pravin2007-ctrl/UV_Guard_IoT_project/uv_product_image/WhatsApp Image 2026-10-07 at 12.01.07 PM.jpeg

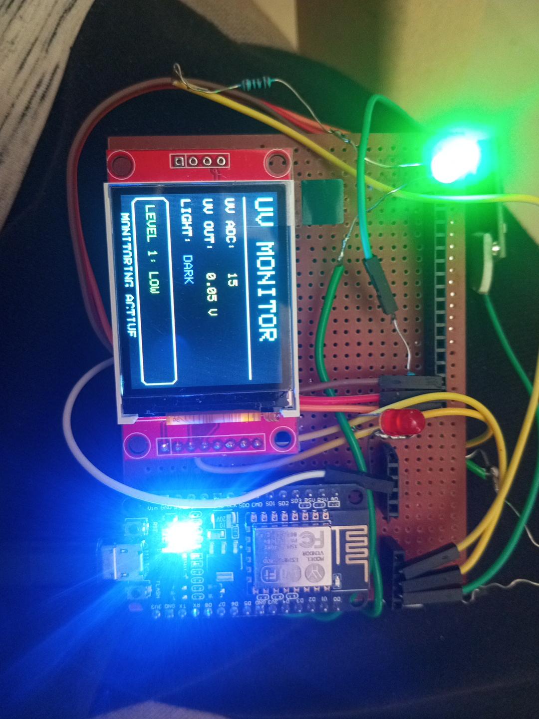
uv_product_image/WhatsApp Image 2026-10-07 at 12.01.07 PM.jpeg
