pravin2007-ctrl/UV_Guard_IoT_project/uv_product_image/38c1b2d2-1b30-4ac0-9bd5-d0442b546b4b.jpg

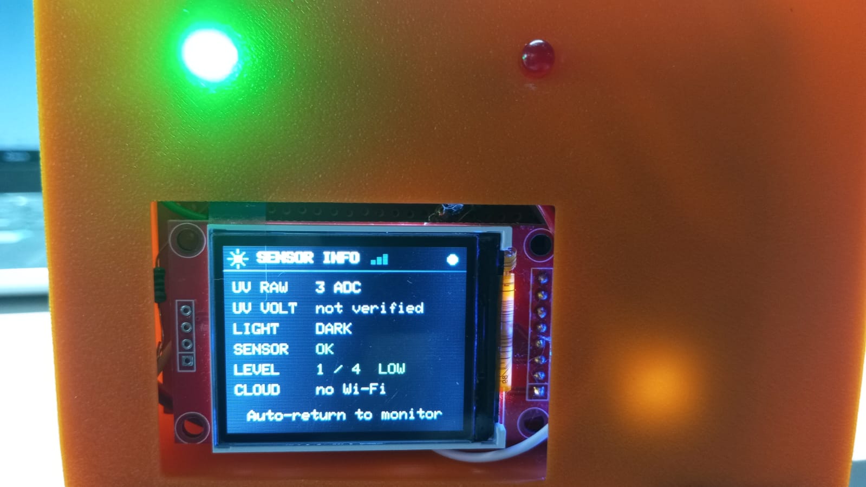
uv_product_image/38c1b2d2-1b30-4ac0-9bd5-d0442b546b4b.jpg
