pravin2007-ctrl/UV_Guard_IoT_project/UV_Guard_Final.pptx

Smart UV Risk Classification and Ambient Light Monitoring System Using ESP8266 with ThingSpeak Cloud Connectivity

STUDENT NAME

Pravin A

REGISTER NUMBER

722824106121

YEAR / DEPT / SECTION

III Year / ECE / C

COURSE CODE & NAME

U23EC492 - IoT and Application

DATE

SDG ADDRESSED

SDG 3 - Good Health & Well-being
SDG 7 - Affordable & Clean Energy

Supervisor: Dr. S. Ramalingam, AP/ECE | Sri Eshwar College of Engineering, Coimbatore

TRL

TRL 4 - Experimental Proof of Concept

## Introduction

BACKGROUND

- UV radiation (100-400 nm) is invisible; UVA and UVB reach the ground
- Causes sunburn, photokeratitis, skin ageing, cataracts, skin cancer

MOTIVATION & IMPORTANCE

- Strong year-round UV in tropical India; outdoor workers and students exposed
- Forecasts are regional; calibrated meters are costly

TECHNICAL CONTEXT

- ESP8266 NodeMCU reads an analog UV sensor (10-bit ADC, 0-1023)
- LDR light state, TFT + LEDs, ThingSpeak upload over Wi-Fi

PROJECT OBJECTIVES

- Measure, filter and classify UV into 4 levels with hysteresis
- Local TFT/LED alert; 16 s cloud upload; works offline; test mode

## Problem Statement

THE PROBLEM

- UV cannot be seen or felt, so safe/unsafe levels cannot be judged by eye
- No affordable, local, real-time notification between forecasts and costly meters
- Hobby designs print raw values: no risk level, advice or light context

IMPACT

- Exposure is underestimated, even on hazy or cloudy days
- Risk of sunburn, eye damage and skin cancer for outdoor workers and students
- Uncalibrated 'UV Index' claims can mislead users

NEED FOR THE SOLUTION

- Low-cost, portable, local UV measurement
- Named risk levels with colour, LEDs and advice
- Stable readings; no display flicker
- Works offline; cloud monitoring optional

## Literature Survey

Approach | Methodology | Findings / strengths | Limitations
Professional UV meters | Calibrated detector with erythemal weighting | Most trustworthy local readings | High cost; needs trained interpretation
Forecast apps / websites | UV Index estimated from solar elevation, ozone, cloud | Free and widely available | Regional; ignores shade, reflection, altitude
Wearable UV sensors | Body-worn sensors or patches with phone link | Personal exposure tracking | Orientation-dependent accuracy; consumer products
Microcontroller UV monitors | Analog/digital UV sensor on Arduino/ESP; serial, LCD/OLED; ThingSpeak or Blynk | Low cost and flexible | Raw voltages shown as UV Index; calibration not described
IoT environmental stations | Multi-sensor node (UV, temperature, humidity, pressure) to cloud | Long-term records | Needs network to view; no local alert

## Existing Solutions & Gaps Analyzed

EXISTING APPROACHES AND LIMITS

- Professional meters: accurate but costly, number only
- Forecast apps: regional, not at the user's spot
- Wearables: placement-dependent, single-purpose
- Hobby monitors: raw values, uncalibrated, basic UI
- IoT stations: network-dependent, no local alert
- Unfiltered ADC noise; full-screen redraw flicker

GAPS ADDRESSED BY UV GUARD

- Local, low-cost UV sensing at the device
- Four named levels with colour and advice
- Instant green/red LED alert
- Averaging, smoothing, hysteresis, partial redraw
- LDR bright/dark context for readings
- Local operation continues without Wi-Fi
- Value labelled as raw ADC until calibrated

## Proposed Solution

Sample UV on A0 every 25 ms

1 s mean + exponential filter

Classify L1-L4 with hysteresis

Update TFT and LEDs

Upload to ThingSpeak every 16 s

IMPLEMENTED

- 4 levels: LOW, MODERATE, HIGH, VERY HIGH (placeholder thresholds 100/200/300)
- LDR bright/dark with 3 s debounce
- 3-screen TFT dashboard; green (L1-2) / red (L3-4) LEDs
- NO SIGNAL / SATURATED sensor checks
- Serial test mode (levels forced 15 s)
- ThingSpeak upload; offline operation

## Block Diagram

UV Guard Smart Monitoring Block Diagram

## Prototype Image (Hardware)

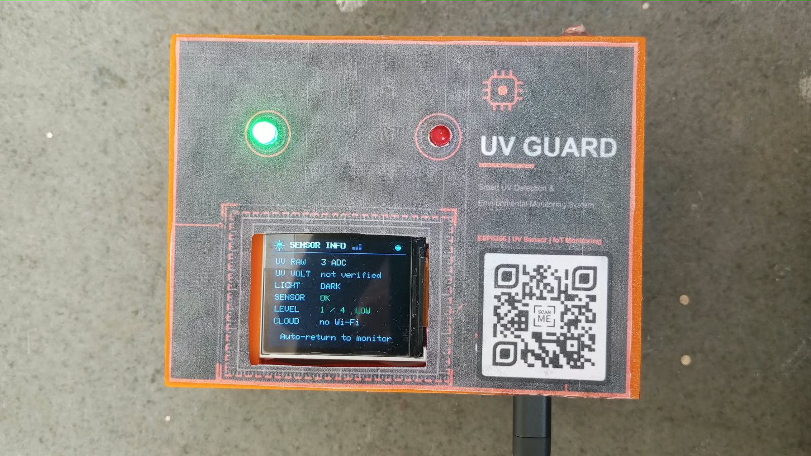
[picture p20: figure]
Enclosure with display

VISIBLE IN PHOTOS

- NodeMCU ESP8266
- 1.8" ST7735 TFT
- UV sensor and LDR
- Green and red LEDs
- 3D-printed case with QR label
- USB power cable

Report lists an enclosure as future work, but the cost sheet includes a 3D-printed case. Confirm.

## Prototype Image (Software): Primary Interface

Remote dashboard: UV sensor ADC vs time from cloud uploads. The report calls it ThingSpeak, but the UI looks like a custom page - confirm.

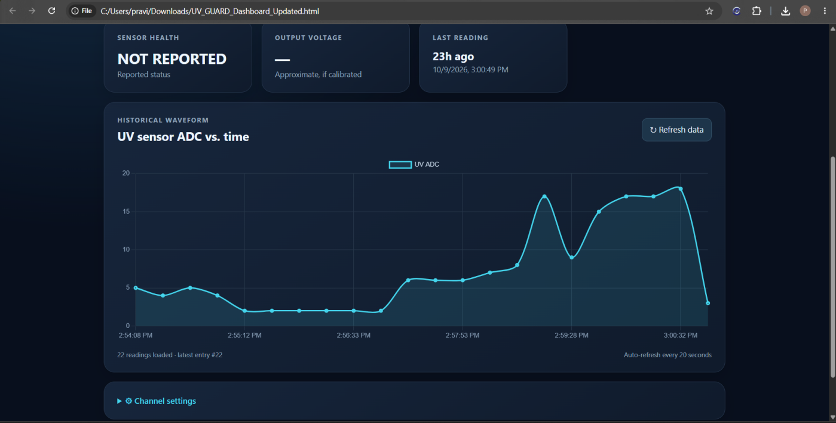
[picture p21: figure]
Cloud dashboard

On-device TFT startup screen

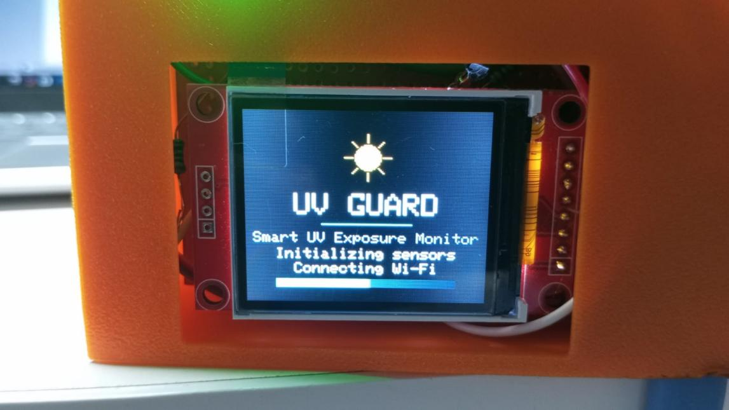
[picture p22: figure]
TFT startup screen

## Prototype Image (Software): Results / Output

Arduino IDE serial monitor: one line per second with raw value, level, light, sensor and cloud status; cloud upload entries.

Serial monitor

Values from the report's field-test table (Table 14); charted here for display.

- Levels and LEDs verified by forcing levels 1-4 (test mode); cloud, offline and failed-upload behaviour tested
- Raw ADC counts, placeholder thresholds: levels are 'sensor risk', not UV Index
- Report lists the shade reading (120) with light state 'off' - confirm

## Technology Stack Used

CONTROLLER & SENSORS

- NodeMCU ESP8266 (ESP-12E), 80 MHz, Wi-Fi
- Analog UV sensor (GUVA-S12SD or similar)
- 5 mm LDR with 10 k divider

DISPLAY & ALERTS

- 1.8" 128x160 ST7735 SPI TFT
- Green and red LEDs (220 ohm)
- 3D-printed enclosure (cost sheet)

COMMUNICATION

- ADC (A0), GPIO, hardware SPI
- UART / USB serial, 115200 baud
- Wi-Fi 802.11 b/g/n; HTTP over TCP/IP

SOFTWARE

- C++ on Arduino framework; Arduino IDE
- ESP8266 core, ESP8266WiFi, HTTPClient
- Adafruit GFX, ST7735/ST7789, SPI

CLOUD

- ThingSpeak channel (3 fields)
- Upload every 16 s (free tier limit)
- Credentials kept in secrets.h

SIMULATION TOOLS

- None stated in the report
- Testing by serial monitor and field readings

## Specifications: Hardware Components

S.No. | Hardware Components | Specifications | Cost (Rs.)
1 | NodeMCU ESP8266 (ESP-12E) x1 | 80 MHz, integrated Wi-Fi, USB, 10-bit ADC (A0) | 350
2 | Analog UV sensor x1 | Analog output to A0; exact model to be confirmed | 200
3 | 1.8" TFT, ST7735 x1 | 128 x 160, SPI, 3.3 V, landscape use | 370
4 | 5 mm LDR x1 | Two-terminal; bright/dark input on D1 | 40
5 | Resistors: 10 k x1, 220 ohm x2 | LDR divider; LED current limiting | 10
6 | Green LED x1, Red LED x1 | On D2 (levels 1-2) and D0 (levels 3-4) | 10
7 | Jumper wires | As required | 100
8 | Dotboard | 1 piece, circuit assembly | 100
9 | USB cable | Programming and 5 V power | 100
10 | 3D-printed case x1 | Enclosure (cost sheet only) | 150
11 | Product sticker x1 | Label | 20
| Total (sum of line items) | | 1,400

## Specifications: Software

Category | Item / specification | Remarks
Development | Arduino IDE; board NodeMCU 1.0 (ESP-12E Module) | Version not stated
Language / firmware | C++ (Arduino framework, ESP8266 core) | Non-blocking loop using millis()
Libraries | ESP8266WiFi, ESP8266HTTPClient, WiFiClient, SPI | Wi-Fi, HTTP upload, display bus
Display libraries | Adafruit GFX; Adafruit ST7735 and ST7789 | Version not stated
Cloud platform | ThingSpeak: field 1 ADC level | Upload every 16 s; HTTP timeout 2 s
Signal processing | 25 ms samples; 1 s mean; exponential filter | Hysteresis 8 counts
Thresholds | 100 / 200 / 300 raw ADC counts (placeholders) | Calibration pending
Timing / reliability | LDR debounce 3 s; Wi-Fi retry 20 s | Test mode forces level 15 s

## Conclusions

UV Guard: a low-cost ESP8266 device that measures UV, classifies it into four risk levels, alerts locally on a TFT and LEDs, and uploads to ThingSpeak.

- All 8 objectives met per report (Table 18)
- Levels and LEDs verified in test mode
- Field readings 2 to 400 raw ADC across 5 conditions
- Uploads about every 16 s; local alerts continue offline

ACHIEVED AND TESTED

## References

[1] WHO, WMO, UNEP and ICNIRP, Global Solar UV Index: A Practical Guide. Geneva: WHO, 2002.
[2] Espressif Systems, ESP8266EX Datasheet.
[3] ESP8266 Community, "Arduino core for ESP8266 WiFi chip," GitHub. https://github.com/esp8266/Arduino
[4] Adafruit Industries, "Adafruit GFX Graphics Library," GitHub. https://github.com/adafruit/Adafruit-GFX-Library
[5] Adafruit Industries, "Adafruit ST7735 and ST7789 Library," GitHub. https://github.com/adafruit/Adafruit-ST7735-Library
[6] The MathWorks, "ThingSpeak IoT Analytics Platform." https://thingspeak.com

[7] GenUV, GUVA-S12SD UV Light Sensor Datasheet.
[8] LAPIS Semiconductor, ML8511 UV Sensor with Voltage Output Datasheet.
[9] Vishay Semiconductors, VEML6075 UVA and UVB Light Sensor with I2C Interface Datasheet.
[10] Lite-On Technology, LTR-390UV-01 Ambient and UV Light Sensor Datasheet.
[11] Silicon Laboratories, Si1145/46/47 Proximity, UV and Ambient Light Sensor IC Datasheet.
[12] Sitronix Technology, ST7735R 262K Color Single-Chip TFT Controller/Driver Datasheet.

## Slide 16

Thank You

Questions and suggestions are welcome

UV Guard | Pravin A | 722824106121
