pravin2007-ctrl/UV_Guard_IoT_project/UV_Guard_Review1.pptx

PROJECT REVIEW 1 | UV GUARD

Smart UV Risk Classification and Ambient Light Monitoring System Using ESP8266 with ThingSpeak Cloud Connectivity

STUDENT NAME

Pravin A

REGISTER NUMBER

722824106121

YEAR / DEPT / SECTION

III Year / ECE / C

COURSE CODE & NAME

U23EC492 - IoT and Application

SDG ADDRESSED

SDG 3 - Good Health & Well-being
SDG 7 - Affordable & Clean Energy

TRL

TRL 4 - Experimental Proof of Concept

REVIEW & DATE

Review 1 |

Supervisor: Dr. S. Ramalingam, AP/ECE | Sri Eshwar College of Engineering, Coimbatore

## Introduction

Invisible risk: UV radiation (100-400 nm) from the Sun cannot be seen or felt, so exposure is easily underestimated.
Health impact: sunburn, photokeratitis, premature skin ageing, cataracts and skin cancer.
Who is exposed: outdoor workers, students and sports participants in tropical India.
Opportunity: an inexpensive analog UV sensor plus the Wi-Fi ESP8266 can warn users where they actually stand.

WHO GLOBAL SOLAR UV INDEX

Low

0-2

Moderate

3-5

High

6-7

Very High

8-10

Objective: a low-cost, portable device that measures UV, classifies risk and alerts the user locally, with optional cloud monitoring.

## Problem Statement

UV is invisible and heat does not track its intensity, so risk cannot be judged by eye

CORE PROBLEM

Design a low-cost, portable embedded system that continuously measures UV radiation, classifies it into easily understood risk categories, and notifies the user through a display and LEDs, while staying extensible to cloud monitoring.

1

2

3

4

5

Weather-app forecasts are regional, not specific to the user's exact spot

Professional UV meters are costly and show a bare number to interpret

Hobby builds print raw sensor values with no risk level, advice or light context

Noisy readings and screen flicker make low-cost displays hard to trust

## Literature Survey

Professional UV meters

Calibrated, erythemal-weighted readings; accurate but costly [1]

Forecast apps

UV Index estimated from sun angle, ozone and cloud; free but regional [1]

Wearable sensors

Personal exposure tracking with phone link; accuracy depends on placement

Microcontroller monitors

Arduino/ESP boards with UV sensors; cheap but often uncalibrated raw values

IoT weather stations

Multi-sensor nodes with cloud dashboards; no direct local alert

1

2

3

4

5

UV SENSOR

Analog (GUVA-S12SD, ML8511) chosen over I2C digital (VEML6075, LTR390, SI1145) for simplicity

CONTROLLER

ESP8266: built-in Wi-Fi at low cost, vs Arduino Uno (no Wi-Fi) and ESP32 (costlier)

NOTIFICATION

Colour TFT plus LEDs preferred over buzzer, OLED or app-only alerts

## Existing Solutions & Gaps Analyzed

Gap in existing solutions | Effect on the user | UV Guard response
High cost of calibrated meters | Out of reach for schools and small farms | Low-cost parts; Rs. 1,400 total build
Regional forecast only | Local exposure unknown | Measures UV at the device location
Raw numbers, no meaning | Risk is hard to understand | 4 named levels with colour and advice
No immediate local alert | Warning may be missed | Green / red LEDs switch instantly
Noisy readings and flicker | Display looks unreliable | Averaging, hysteresis, partial redraw
Unclear calibration | Misleading UV Index claims | Shown as raw ADC; calibration planned
Network dependence | No data when offline | Local alerts work offline; cloud optional

## Proposed Solution: UV Guard

INPUT

UV Sensor
analog output to A0

PROCESSING

ESP8266 NodeMCU

Sample every 25 ms
1 s average + smoothing
4-level classification
Hysteresis and sensor checks

OUTPUT

1.8" TFT dashboard (SPI)

Green / Red LEDs

Wi-Fi to ThingSpeak cloud

LDR + 10 k
bright / dark to D1

LOW

ADC < 100 | Green LED

MODERATE

ADC 100+ | Green LED

HIGH

ADC 200+ | Red LED

VERY HIGH

ADC 300+ | Red LED

Thresholds are placeholders pending calibration; an 8-count hysteresis prevents level flicker.

## Proposed Work Plan

REVIEW 1

Foundation & Hardware

- Problem identification and objectives
- Literature survey and gap analysis
- Component selection: sensor, controller, display
- Breadboard assembly; TFT, LDR and UV sensor tests

REVIEW 2

Firmware & Cloud

- Sampling, filtering and hysteresis classification
- LED alerts and 3-screen TFT dashboard
- Wi-Fi and ThingSpeak upload every 16 s
- Serial test mode and integration testing

REVIEW 3

Calibration & Demo

- Field testing in 5 light conditions
- Calibrate against a reference UV meter
- Secure upload via HTTPS / MQTT
- Enclosure, final report and demo

## References

[1] WHO, WMO, UNEP and ICNIRP, Global Solar UV Index: A Practical Guide. Geneva: WHO, 2002.
[2] Espressif Systems, ESP8266EX Datasheet.
[3] ESP8266 Community, "Arduino core for ESP8266 WiFi chip," GitHub. github.com/esp8266/Arduino
[4] Adafruit Industries, "Adafruit GFX Graphics Library," GitHub.
[5] Adafruit Industries, "Adafruit ST7735 and ST7789 Library," GitHub.
[6] The MathWorks, "ThingSpeak IoT Analytics Platform." thingspeak.com

[7] GenUV, GUVA-S12SD UV Light Sensor Datasheet.
[8] LAPIS Semiconductor, ML8511 UV Sensor with Voltage Output Datasheet.
[9] Vishay Semiconductors, VEML6075 UVA and UVB Light Sensor Datasheet.
[10] Lite-On Technology, LTR-390UV-01 Ambient and UV Light Sensor Datasheet.
[11] Silicon Laboratories, Si1145/46/47 Proximity, UV and Ambient Light Sensor IC Datasheet.
[12] Sitronix Technology, ST7735R 262K Color Single-Chip TFT Controller/Driver Datasheet.

## Work Progress to Date

COMPLETED

Hardware assembly and unit tests

✓

✓

Firmware: sampling, filter, hysteresis

PENDING

TFT dashboard (3 screens), no flicker

LED alerts and serial test mode

ThingSpeak upload every 16 s, offline-safe

Field tests in 5 light conditions

Calibrate thresholds with a reference UV meter

Rs. 1,400

total estimated build cost

TRL 4

proof of concept

## Slide 10

Thank You

Questions and suggestions are welcome

UV Guard | Pravin A | 722824106121
