pravin2007-ctrl/UV_Guard_IoT_project/uv_product_image/0f6d91bb-43fa-49d1-9486-3ebc0e2a7fdd.jpg

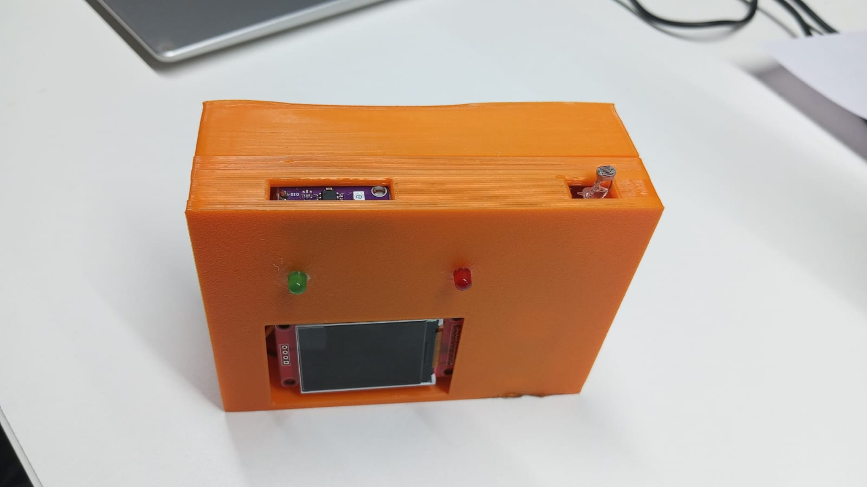
uv_product_image/0f6d91bb-43fa-49d1-9486-3ebc0e2a7fdd.jpg
