pravin2007-ctrl/UV_Guard_IoT_project/uv_product_image/2624dcab-50c5-4c80-ab2c-cfaa2474c6e1.jpg

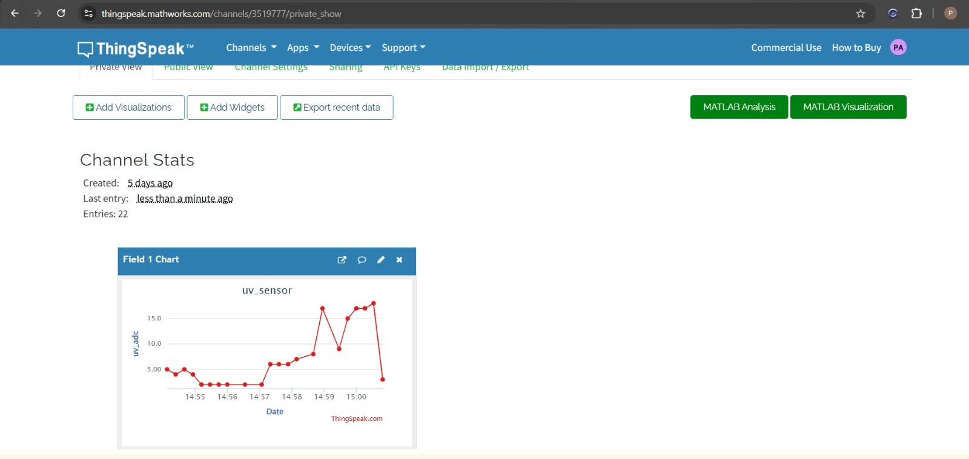
uv_product_image/2624dcab-50c5-4c80-ab2c-cfaa2474c6e1.jpg
