pravin2007-ctrl/UV_Guard_IoT_project/uv_product_image/140946be-8c02-407b-a8a9-64de4218cb17.jpg

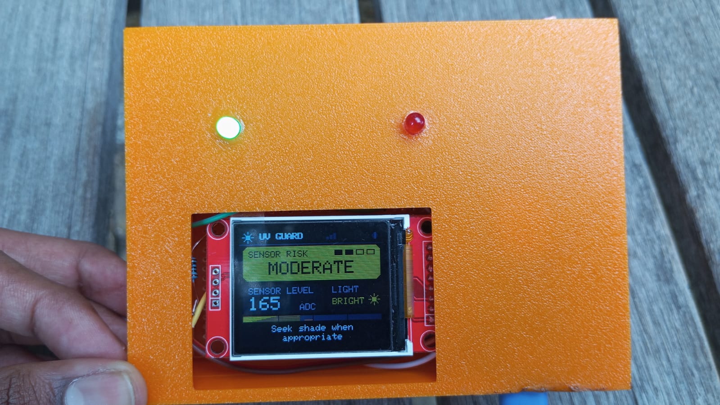
uv_product_image/140946be-8c02-407b-a8a9-64de4218cb17.jpg
