pravin2007-ctrl/UV_Guard_IoT_project/uv_product_image/FINAL_PRODUCT_PREVIEW.png

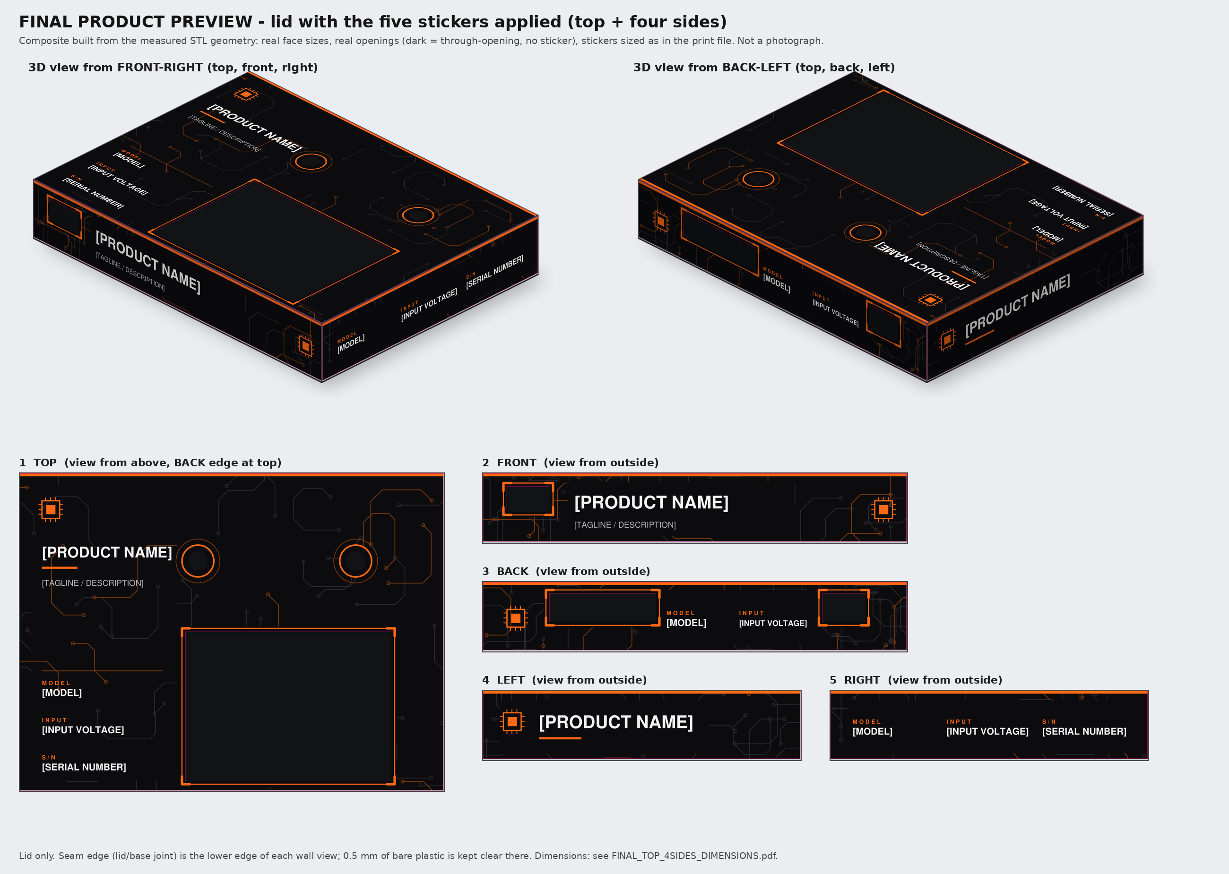
uv_product_image/FINAL_PRODUCT_PREVIEW.png
