pravin2007-ctrl/UV_Guard_IoT_project/uv_product_image/https_creative-alpaca-802f77_netlify_app_.png

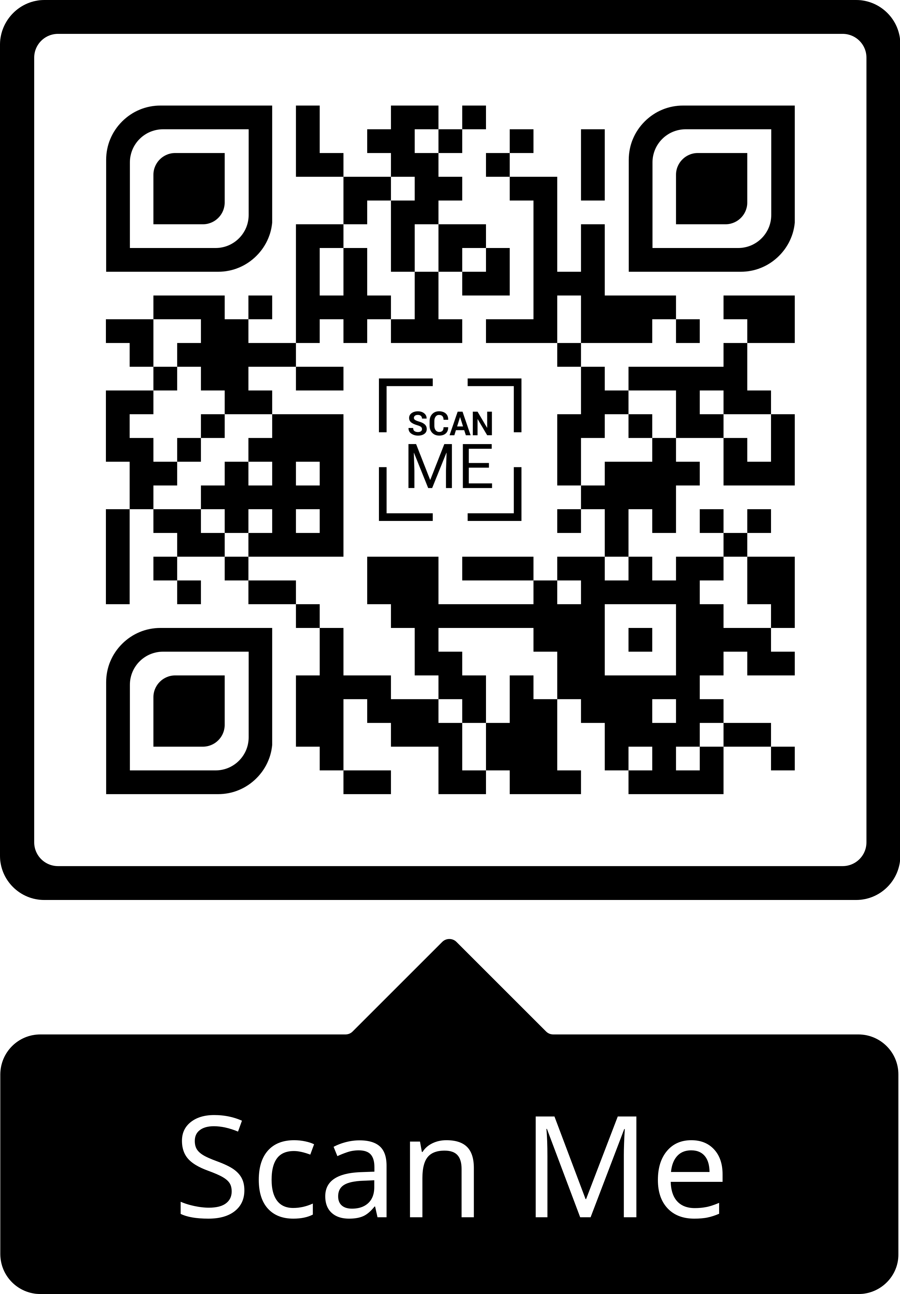
uv_product_image/https_creative-alpaca-802f77_netlify_app_.png
