pravin2007-ctrl/UV_Guard_IoT_project/uv_product_image/UV GUARD Circuit Diagram.png

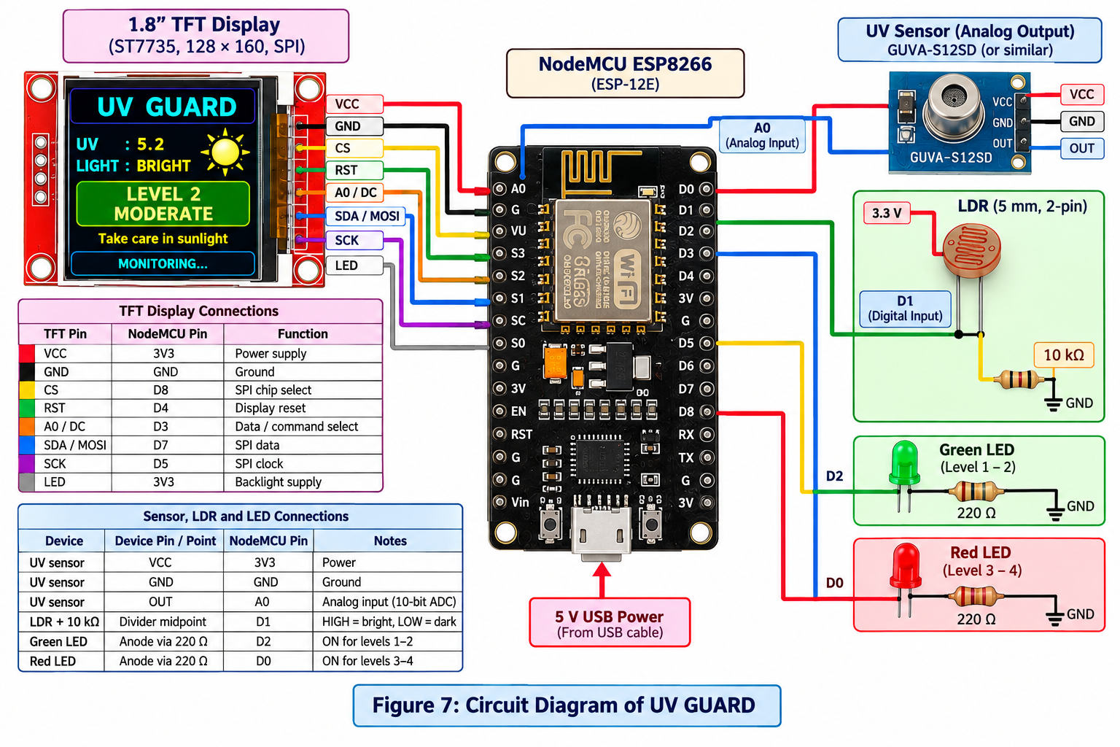
uv_product_image/UV GUARD Circuit Diagram.png
