pravin2007-ctrl/UV_Guard_IoT_project/uv_product_image/UV Guard Desktop Monitoring Device.png

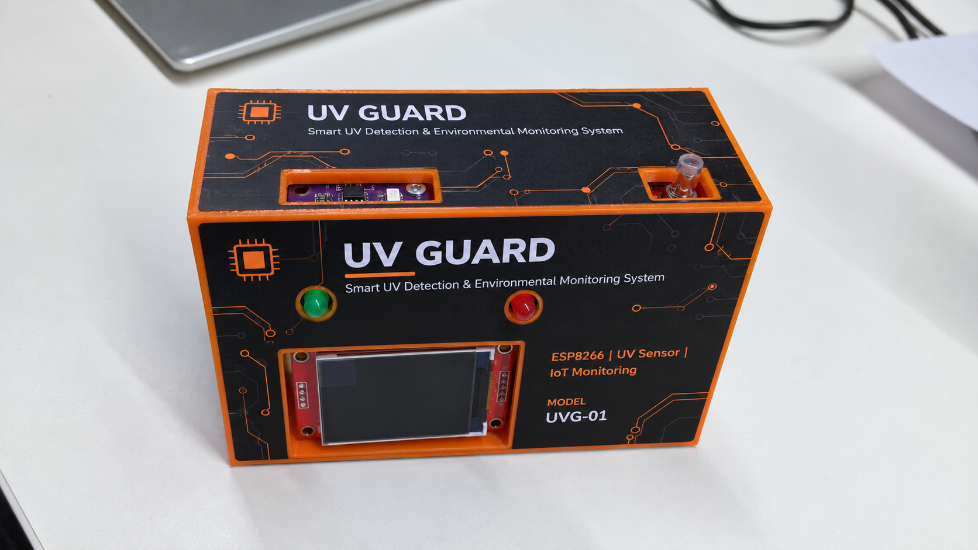
uv_product_image/UV Guard Desktop Monitoring Device.png
