pravin2007-ctrl/UV_Guard_IoT_project/uv_product_image/WhatsApp Image 2026-10-27 at 4.18.22 PM.jpeg

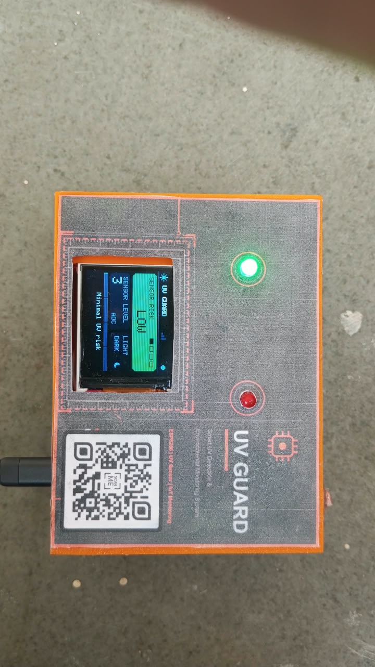
uv_product_image/WhatsApp Image 2026-10-27 at 4.18.22 PM.jpeg
